miek/usb3-fixtures/microstrip-test/microstrip-test.kicad_pcb

## KiCad design microstrip-test/microstrip-test.kicad_pcb (2022-09-05)

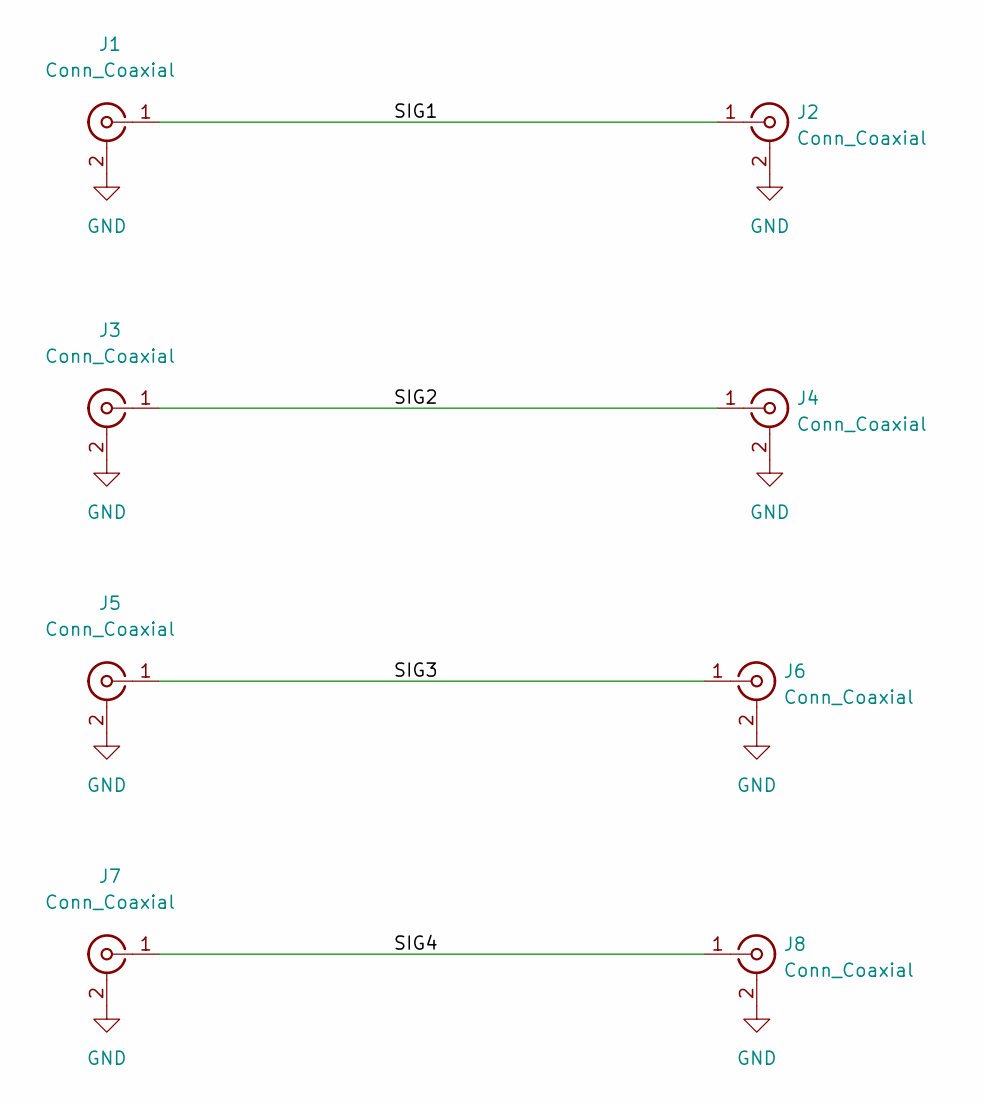
[picture p5: schematic microstrip-test.kicad_sch]

Parts:
J1, J2, J3, J4, J5, J6, J7, J8: Conn_Coaxial; CONN_SMA_EDGE_ROSENBERGER_32K243_40ML5

Connections:
/SIG1: J1.1 (In), J2.1 (In)
/SIG2: J3.1 (In), J4.1 (In)
/SIG3: J5.1 (In), J6.1 (In)
/SIG4: J7.1 (In), J8.1 (In)
GND: J1.2 (Ext), J2.2 (Ext), J3.2 (Ext), J4.2 (Ext), J5.2 (Ext), J6.2 (Ext), J7.2 (Ext), J8.2 (Ext)

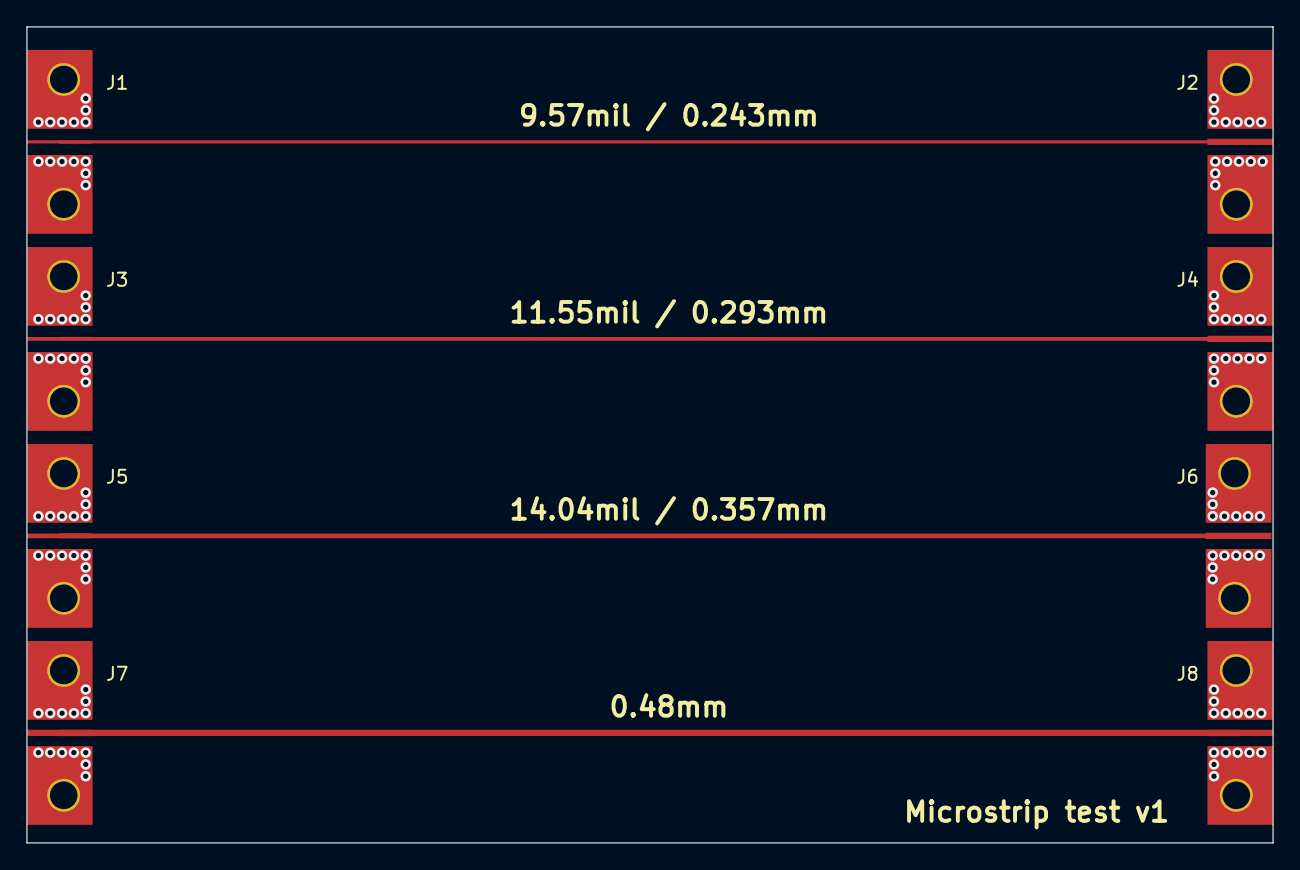
[picture p6: board microstrip-test.kicad_pcb from above]

Board: 4 copper layers, 94.9 x 62.1 mm, 8 parts (0 on the bottom side), 5 nets.
